Sam-de-Ham/MacroRail/docs/images/module-exploded.png

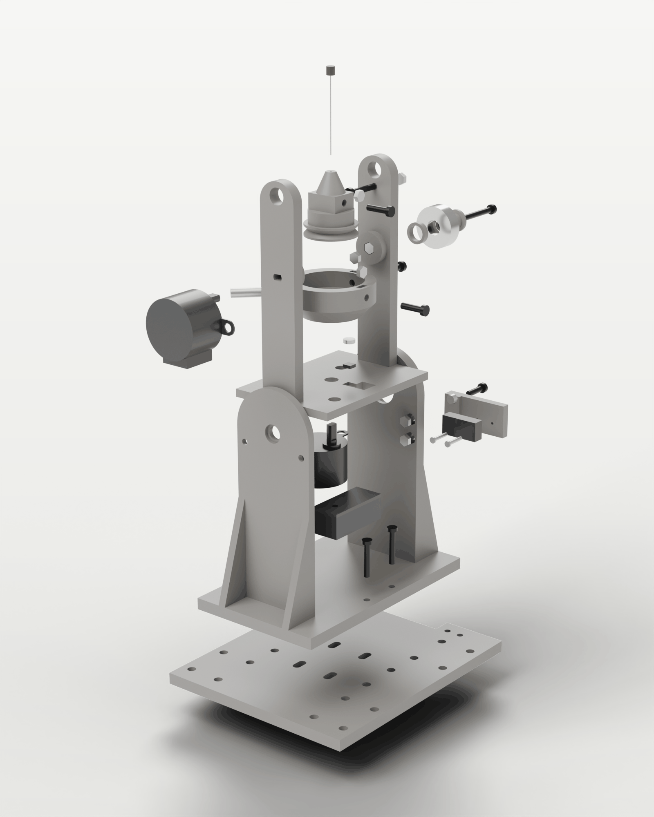
docs/images/module-exploded.png
