Sam-de-Ham/MacroRail/docs/images/rail-exploded.png

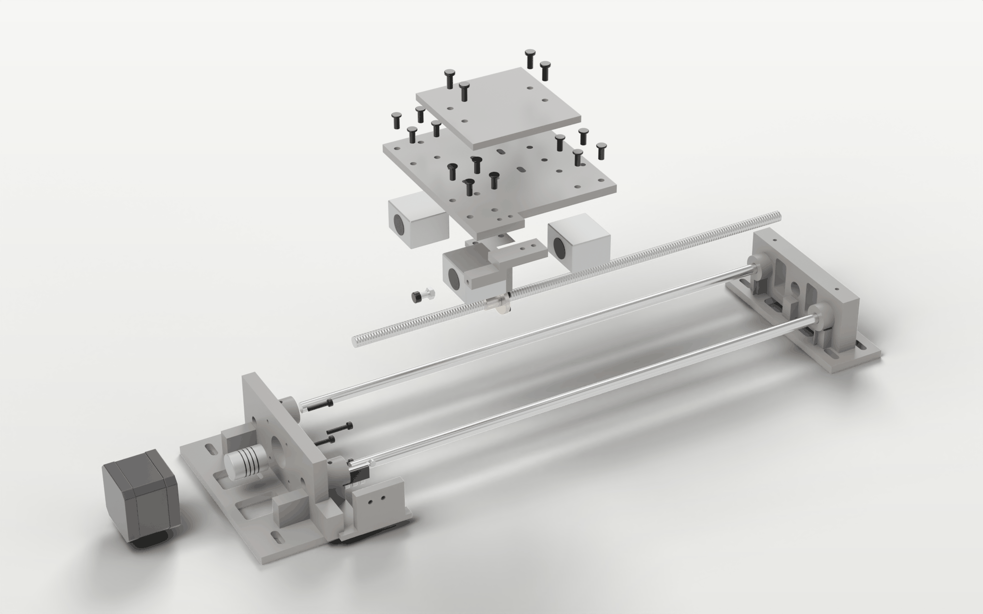
docs/images/rail-exploded.png
