Sam-de-Ham/MacroRail/docs/images/sample/depth.jpg

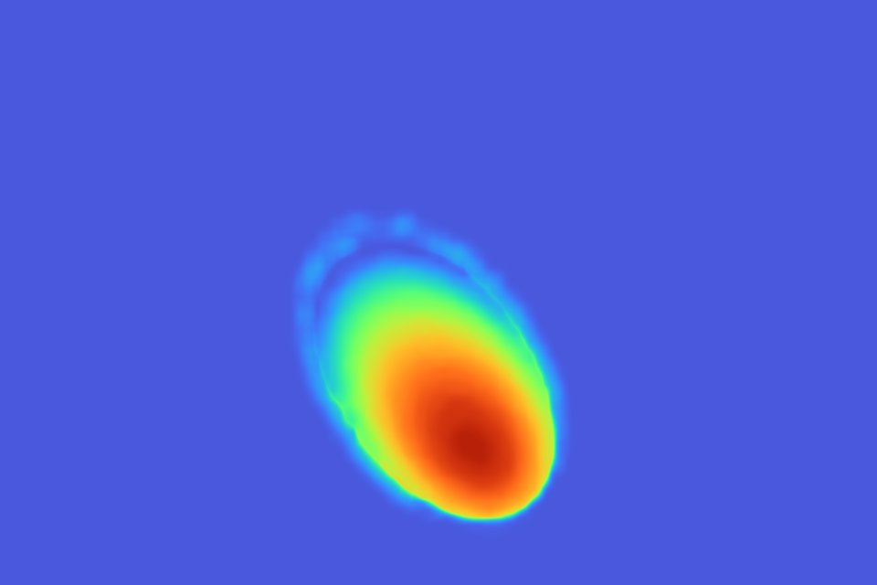
docs/images/sample/depth.jpg
