Sam-de-Ham/MacroRail/docs/images/sample/preview.jpg

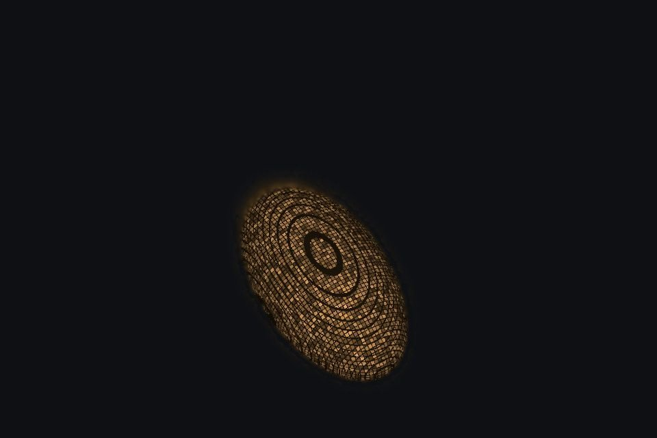
docs/images/sample/preview.jpg
