Sam-de-Ham/MacroRail/docs/images/social-preview.png

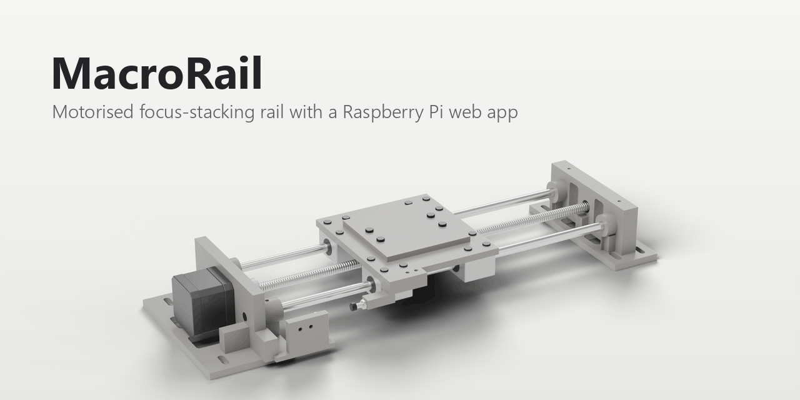
docs/images/social-preview.png
