Sam-de-Ham/MacroRail/hardware/scan-module/exports/final/yaw-head.stl

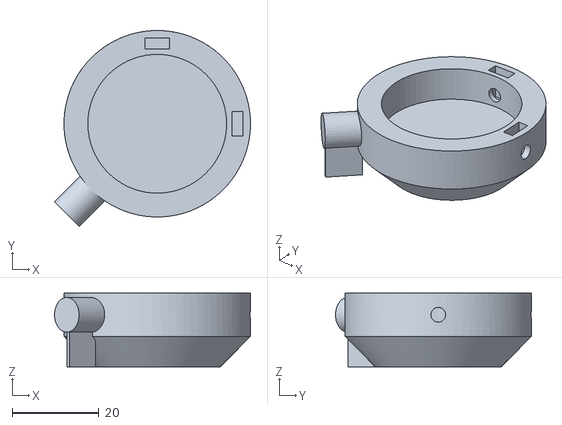
[picture p16: CAD file, 2026-10-23]
hardware/scan-module/exports/final/yaw-head.stl
45.2 x 45.2 x 17.0
