Sam-de-Ham/MacroRail/hardware/rail/stl/05_sample_platform.stl

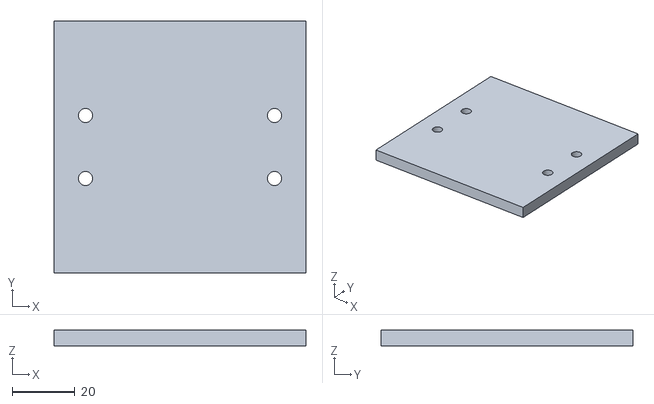
[picture p17: CAD file, 2026-10-18]
hardware/rail/stl/05_sample_platform.stl
80.0 x 80.0 x 5.00
