Sam-de-Ham/MacroRail/hardware/scan-module/exports/final/fork.stl

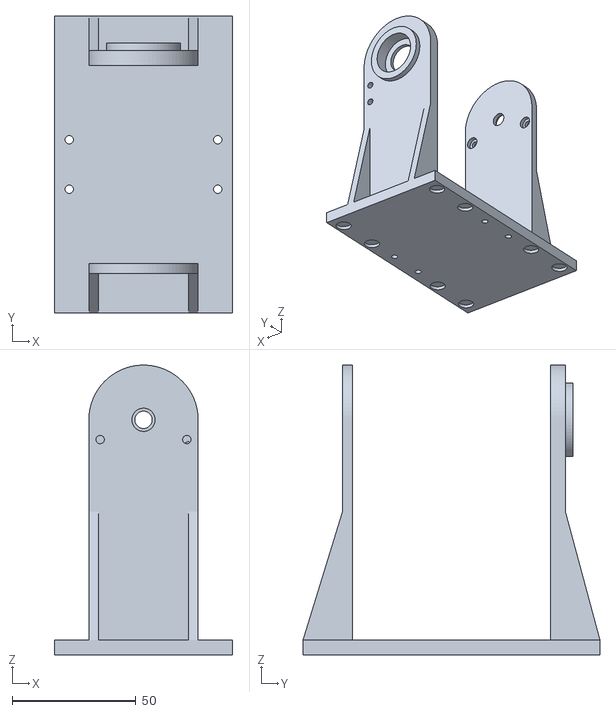
[picture p18: CAD file, 2026-10-22]
hardware/scan-module/exports/final/fork.stl
72.0 x 120.0 x 117.1
