Sam-de-Ham/MacroRail/hardware/scan-module/exports/test-pieces/axle-spacer.stl

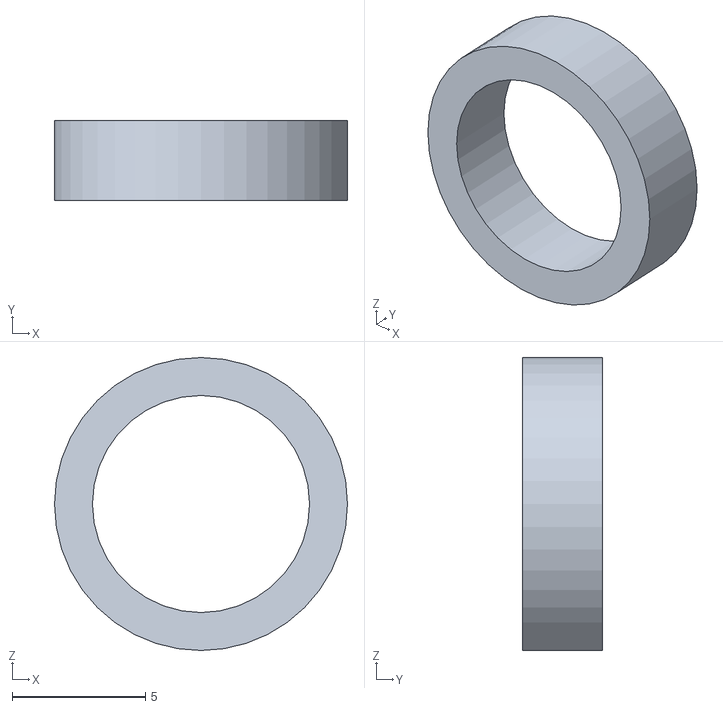
[picture p19: CAD file, 2026-10-22]
hardware/scan-module/exports/test-pieces/axle-spacer.stl
11.0 x 3.00 x 11.0
