Sam-de-Ham/MacroRail/hardware/rail/stl/01_motor_end_block.stl

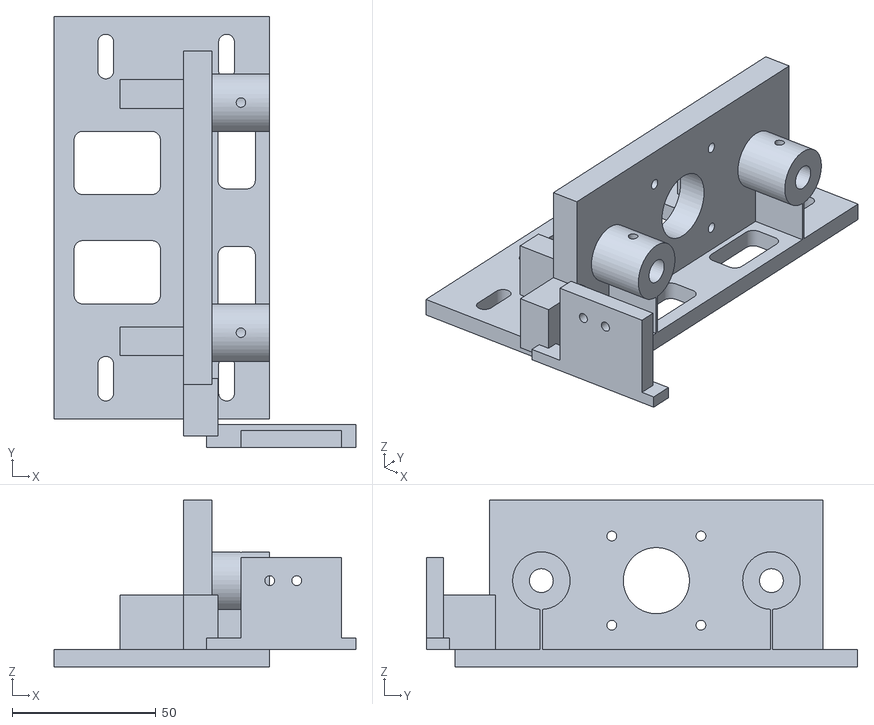
[picture p20: CAD file, 2026-10-18]
hardware/rail/stl/01_motor_end_block.stl
105.0 x 150.0 x 58.0
