Sam-de-Ham/MacroRail/hardware/scan-module/exports/final/cradle.stl

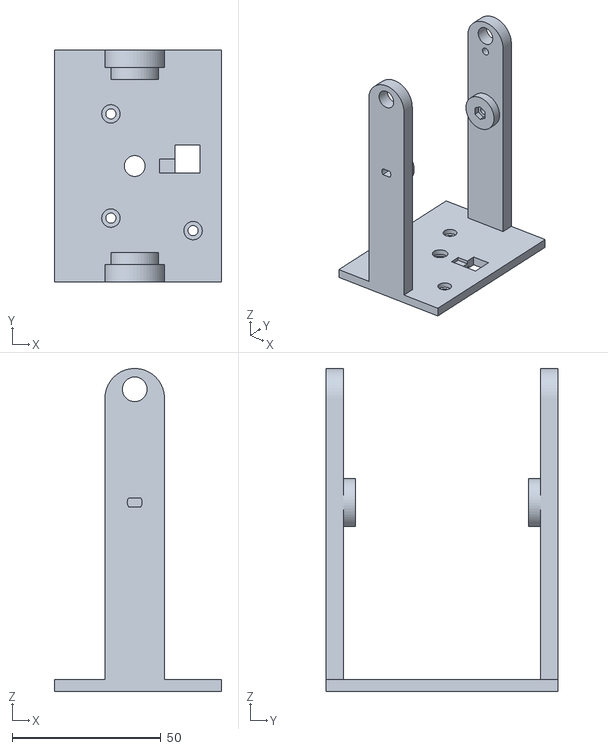
[picture p21: CAD file, 2026-10-22]
hardware/scan-module/exports/final/cradle.stl
56.2 x 78.0 x 108.5
