Sam-de-Ham/MacroRail/hardware/scan-module/exports/test-pieces/specimen-holder.stl

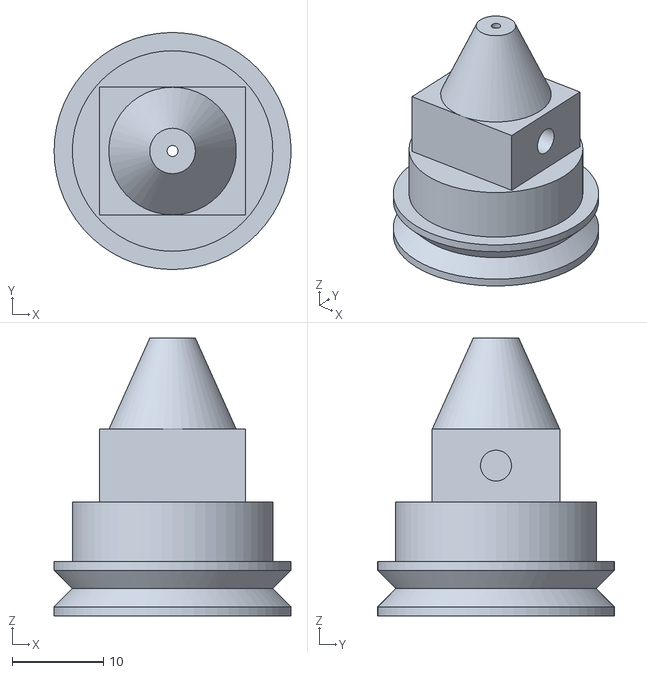
[picture p22: CAD file, 2026-10-22]
hardware/scan-module/exports/test-pieces/specimen-holder.stl
26.0 x 26.0 x 30.5
