Sam-de-Ham/MacroRail/hardware/rail/stl/03_carriage.stl

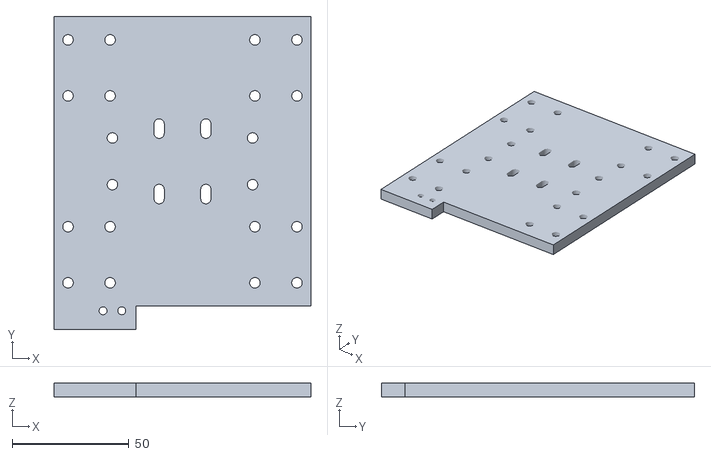
[picture p23: CAD file, 2026-10-18]
hardware/rail/stl/03_carriage.stl
110.0 x 134.0 x 6.00
