Sam-de-Ham/MacroRail/hardware/scan-module/exports/test-pieces/tp-tilt-d-bore.stl

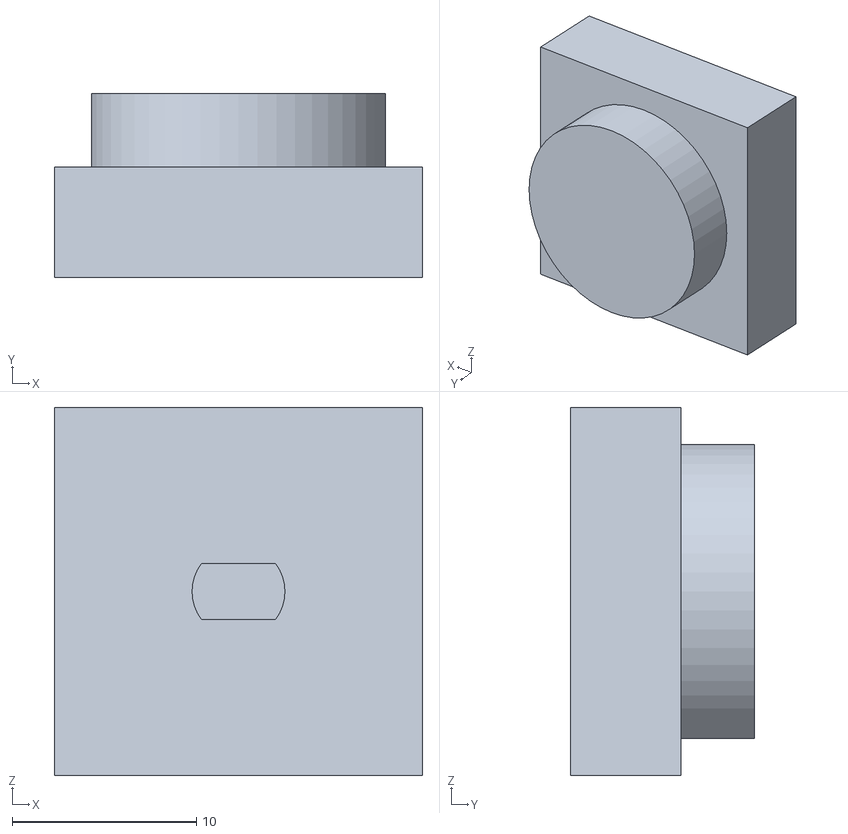
[picture p24: CAD file, 2026-10-22]
hardware/scan-module/exports/test-pieces/tp-tilt-d-bore.stl
20.0 x 10.0 x 20.0
