Sam-de-Ham/MacroRail/hardware/rail/stl/02_far_end_block.stl

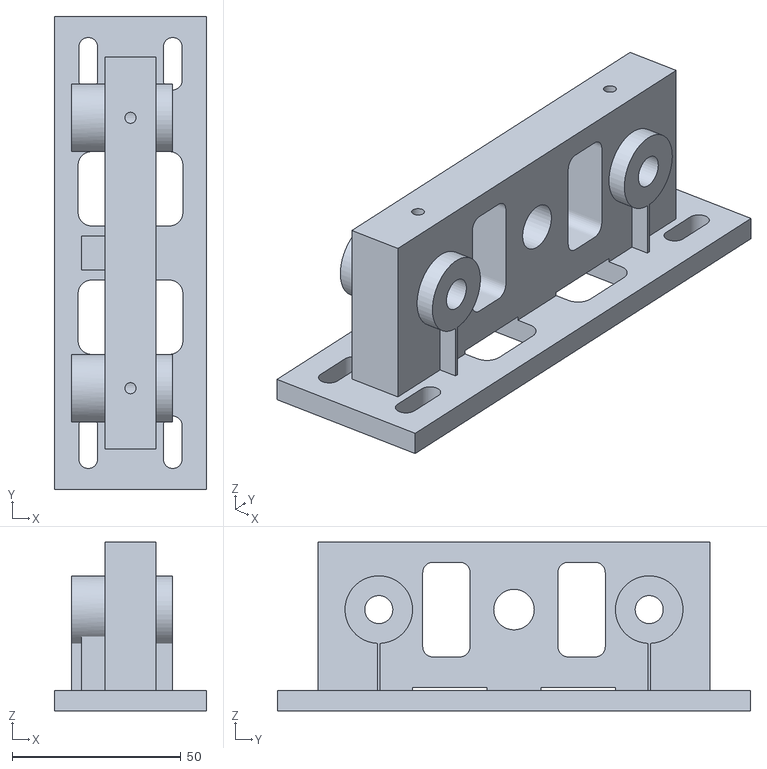
[picture p25: CAD file, 2026-10-18]
hardware/rail/stl/02_far_end_block.stl
45.0 x 140.0 x 50.0
