Sam-de-Ham/MacroRail/hardware/scan-module/exports/final/tilt-axle.stl

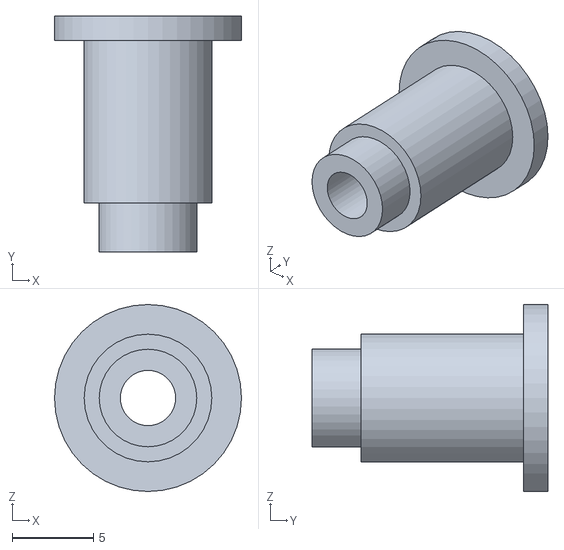
[picture p26: CAD file, 2026-10-22]
hardware/scan-module/exports/final/tilt-axle.stl
11.5 x 14.5 x 11.5
