Sam-de-Ham/MacroRail/hardware/scan-module/exports/test-pieces/tp-bearing-seat.stl

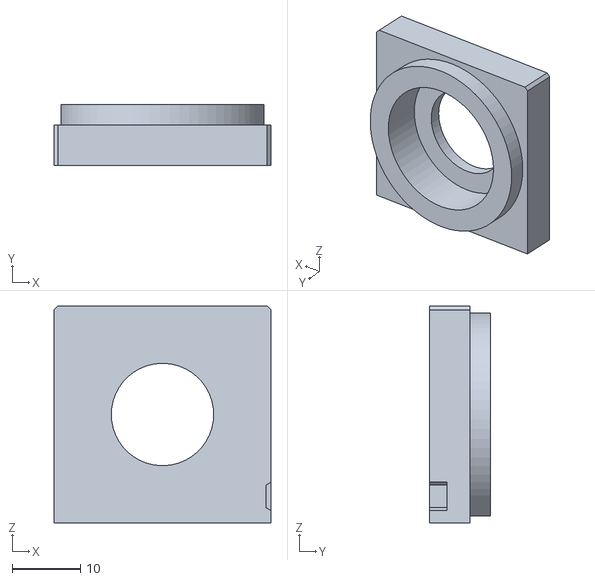
[picture p27: CAD file, 2026-10-22]
hardware/scan-module/exports/test-pieces/tp-bearing-seat.stl
31.8 x 9.00 x 31.8
