Sam-de-Ham/MacroRail/hardware/rail/stl/06_endstop_trigger.stl

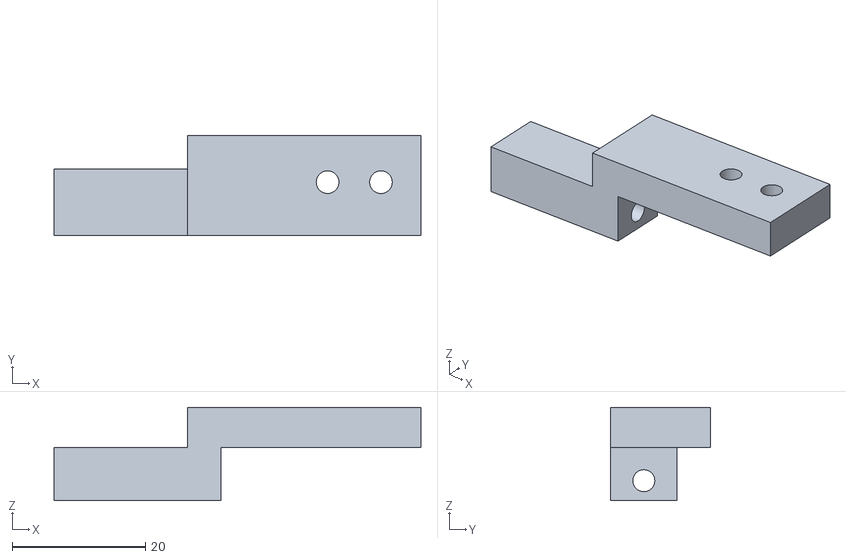
[picture p28: CAD file, 2026-10-18]
hardware/rail/stl/06_endstop_trigger.stl
55.0 x 15.0 x 14.0
