Sam-de-Ham/MacroRail/hardware/scan-module/exports/final/endstop-bracket.stl

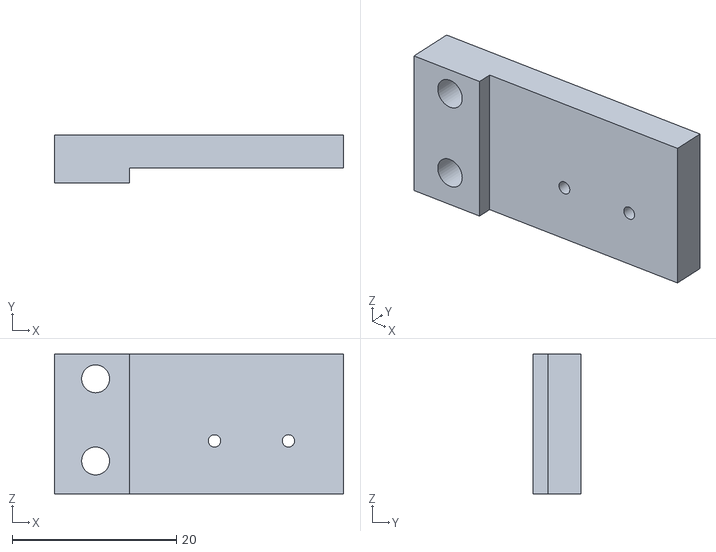
[picture p29: CAD file, 2026-10-21]
hardware/scan-module/exports/final/endstop-bracket.stl
35.2 x 5.80 x 17.0
