Sam-de-Ham/MacroRail/hardware/scan-module/exports/test-pieces/tp-motor-seat.stl

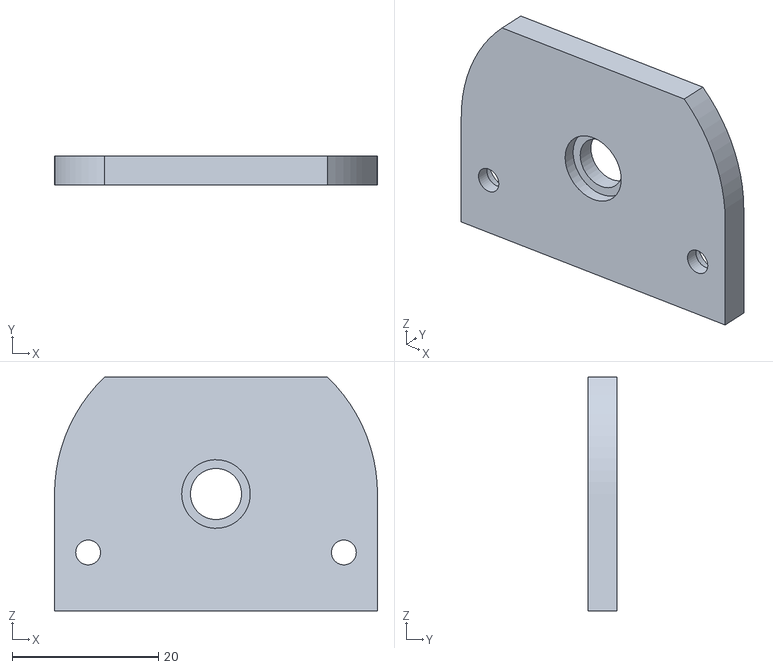
[picture p30: CAD file, 2026-10-22]
hardware/scan-module/exports/test-pieces/tp-motor-seat.stl
44.2 x 4.00 x 32.0
