Sam-de-Ham/MacroRail/hardware/scan-module/exports/final/height-gauge.stl

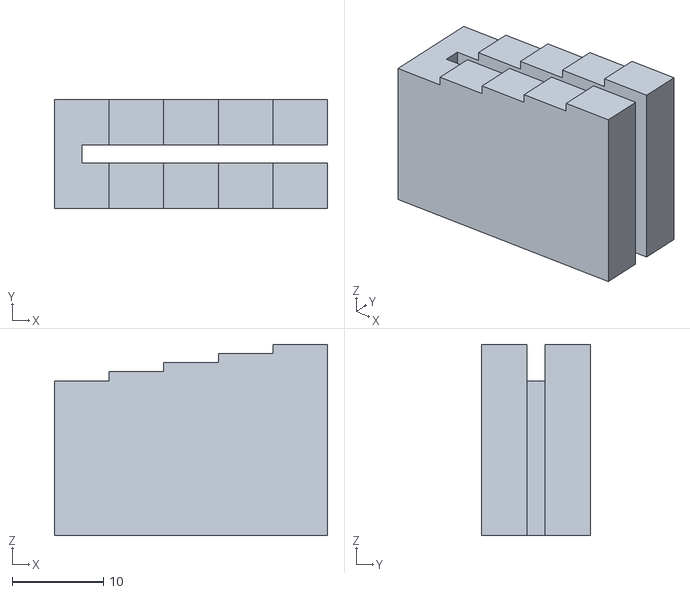
[picture p31: CAD file, 2026-10-21]
hardware/scan-module/exports/final/height-gauge.stl
30.0 x 12.0 x 21.0
