Sam-de-Ham/MacroRail/hardware/scan-module/exports/test-pieces/tp-cradle-floor.stl

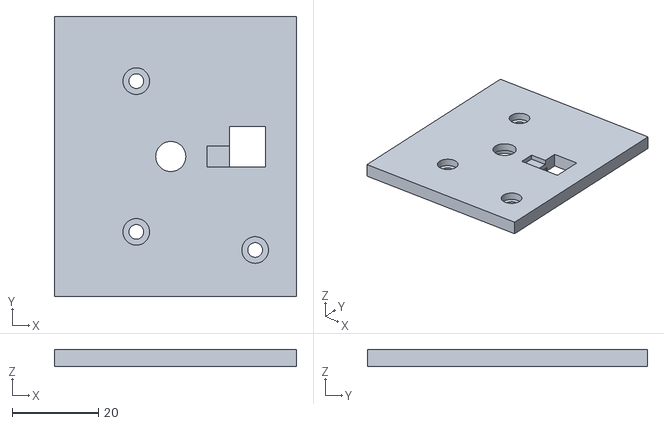
[picture p32: CAD file, 2026-10-21]
hardware/scan-module/exports/test-pieces/tp-cradle-floor.stl
56.2 x 65.0 x 4.00
