Sam-de-Ham/MacroRail/hardware/scan-module/exports/test-pieces/tp-base-holes.stl

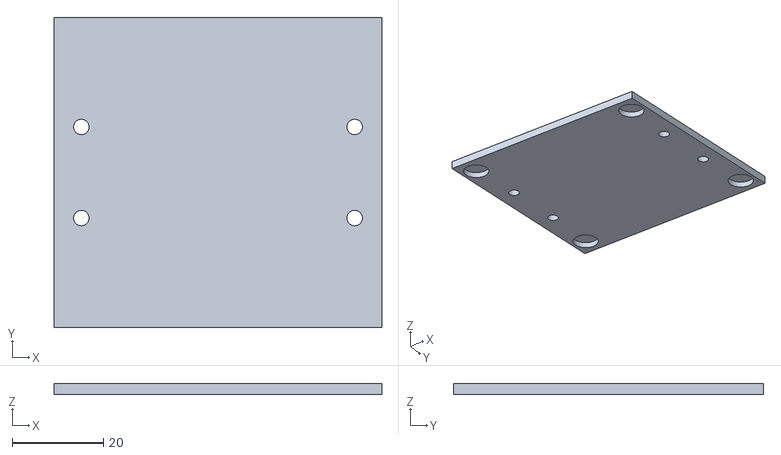
[picture p33: CAD file, 2026-10-21]
hardware/scan-module/exports/test-pieces/tp-base-holes.stl
72.0 x 68.0 x 2.50
