Sam-de-Ham/MacroRail/(list of files, cad)

Other CAD files:
hardware/scan-module/exports/test-pieces/tp-axle-socket.stl
hardware/rail/stl/04_floating_nut_carrier.stl
hardware/scan-module/exports/final/carriage-washer.stl
