Sam-de-Ham/MacroRail/firmware/src/main.cpp

// MacroRail rail controller firmware.
//
// Drives one stepper through a TMC2209 (STEP/DIR for motion, UART for configuration) and
// reads one homing switch. The host talks to it with the line protocol in docs/protocol.md.

#include <AccelStepper.h>
#include <Arduino.h>
#include <TMCStepper.h>

#include "config.h"

namespace {

TMC2209Stepper driver(PIN_UART_RX, PIN_UART_TX, DRIVER_RSENSE_OHM, DRIVER_ADDRESS);
AccelStepper stepper(AccelStepper::DRIVER, PIN_STEP, PIN_DIR);

enum class Motion : uint8_t { None, Move, Jog, HomeSeek, HomeBackoff, HomeProbe };
enum class Abort : uint8_t { None, Stopped, Link };
enum class Fault : uint8_t { None, Overtemp, Short };

struct {
  bool enabled = false;
  bool homed = false;
  bool driverOk = false;
  long minLimit = 0;
  long maxLimit = 0;
  uint16_t runMa = 600;
  uint16_t holdMa = 200;
} state;

struct {
  uint16_t id = 0;
  Motion motion = Motion::None;
  Abort abort = Abort::None;
  bool ignoreSwitch = false;  // backing off a pressed switch: its release bounce must not stop us
  float fast = 0;
  float slow = 0;
  float accel = 0;
  long clearance = 0;   // homing: how far past the release point to back off
  long releaseMax = 0;  // homing: give up if the switch hasn't released by then
  long tripPos = 0;     // homing: where the seek tripped the switch
  long releasePos = 0;  // homing: where it released again (-1 while still pressed)
} pending;

Fault reportedFault = Fault::None;
uint32_t lastRxMs = 0;
uint32_t lastPosMs = 0;
uint32_t lastDriverCheckMs = 0;
float currentAccel = 0;

// ---------------------------------------------------------------------------------------------
// Home switch
//
// A hardware interrupt latches the very first contact, so even a brief touch of a short-throw
// switch stops the motor before its next step, whatever the direction of travel.
// Two latches: `switchTouched` takes any closing edge at all, `switchTripped` only one that is
// still closed when the interrupt runs (a few µs later), which rejects motor-noise spikes.
// Homing expects the switch and uses the first touch, so a chattering contact counts from its
// very first blip; every other motion uses the filtered trip.
// `endstopActive` is the debounced level: it decides whether a move may start, and every
// change of it is reported to the host straight away.

volatile bool switchTouched = false;
volatile bool switchTripped = false;
bool endstopActive = false;
bool endstopRaw = false;
uint32_t endstopChangedUs = 0;
uint32_t endstopSeenUs = 0;  // last time the raw input read "pressed"

bool readEndstopRaw() { return digitalRead(PIN_ENDSTOP) == ENDSTOP_ACTIVE_LEVEL; }

void onSwitchEdge() {
  switchTouched = true;
  if (readEndstopRaw()) switchTripped = true;  // still pressed on entry: not a noise spike
}

void updateEndstop() {
  const bool raw = readEndstopRaw();
  const uint32_t now = micros();
  if (raw) endstopSeenUs = now;
  if (raw != endstopRaw) {
    endstopRaw = raw;
    endstopChangedUs = now;
  } else if (raw != endstopActive && now - endstopChangedUs >= ENDSTOP_DEBOUNCE_US) {
    endstopActive = raw;
    Serial.print(F("! SWITCH pressed="));
    Serial.println(endstopActive);
  }
}

// ---------------------------------------------------------------------------------------------
// Replies and events

void beginReply(uint16_t id) {
  Serial.print(id);
  Serial.print(' ');
}

void replyOk(uint16_t id) {
  beginReply(id);
  Serial.println(F("OK"));
}

void replyOkPos(uint16_t id) {
  beginReply(id);
  Serial.print(F("OK pos="));
  Serial.println(stepper.currentPosition());
}

void replyErr(uint16_t id, const __FlashStringHelper* code) {
  beginReply(id);
  Serial.print(F("ERR "));
  Serial.println(code);
}

void replyErrPos(uint16_t id, const __FlashStringHelper* code) {
  beginReply(id);
  Serial.print(F("ERR "));
  Serial.print(code);
  Serial.print(F(" pos="));
  Serial.println(stepper.currentPosition());
}

void printIdentity() {
  Serial.print(F("fw=" FIRMWARE_VERSION " proto="));
  Serial.print(PROTOCOL_VERSION);
  Serial.print(F(" driver="));
  Serial.println(state.driverOk ? F("ok") : F("missing"));
}

// ---------------------------------------------------------------------------------------------
// Driver

void applyCurrent() {
  driver.rms_current(state.runMa, static_cast<float>(state.holdMa) / state.runMa);
}

bool configureDriver() {
  if (driver.version() != TMC2209_VERSION) return false;
  driver.GSTAT(0);  // clear reset/error flags (write-1-to-clear)
  driver.pdn_disable(true);       // PDN_UART pin is UART, not power-down
  driver.mstep_reg_select(true);  // microsteps from register, not MS1/MS2
  driver.I_scale_analog(false);   // current from register, not VREF
  driver.toff(4);
  driver.microsteps(MICROSTEPS);
  driver.intpol(true);            // interpolate to 256 microsteps
  driver.en_spreadCycle(false);   // StealthChop
  driver.pwm_autoscale(true);
  driver.pwm_autograd(true);
  driver.TCOOLTHRS(0);            // StallGuard/CoolStep unused
  driver.SGTHRS(0);
  driver.semin(0);
  driver.iholddelay(8);
  driver.TPOWERDOWN(20);
  applyCurrent();
  return driver.microsteps() == MICROSTEPS;
}

void disableMotor() {
  stepper.disableOutputs();
  state.enabled = false;
  state.homed = false;
}

void fault(const __FlashStringHelper* code) {
  disableMotor();
  Serial.print(F("! FAULT code="));
  Serial.println(code);
}

// The driver UART (SoftwareSerial) blocks interrupts for each byte, long enough to drop bytes
// arriving from the host and to stall the step loop. So it is used only while answering a host
// request that the host waits for (STATUS when idle, ENABLE, CURRENT), never while moving.
void checkDriver() {
  if (driver.version() != TMC2209_VERSION) {
    if (state.driverOk) {
      state.driverOk = false;
      fault(F("driver_lost"));
    }
    return;
  }
  if (!state.driverOk) {  // came back (e.g. 12 V switched on): configure, motor stays off
    state.driverOk = configureDriver();
    return;
  }
  if (driver.GSTAT() & 0x01) {  // reset: registers lost power
    state.driverOk = configureDriver();
    fault(F("driver_reset"));
    return;
  }
  // Overtemperature and short flags stay set while the condition lasts: report each once.
  Fault now = Fault::None;
  if (driver.ot()) now = Fault::Overtemp;
  else if (driver.s2ga() || driver.s2gb() || driver.s2vsa() || driver.s2vsb()) now = Fault::Short;
  if (now != reportedFault && now != Fault::None) {
    fault(now == Fault::Overtemp ? F("overtemp") : F("short"));
  }
  reportedFault = now;
}

// ---------------------------------------------------------------------------------------------
// Motion

void setProfile(float speed, float accel) {
  stepper.setMaxSpeed(speed);
  if (accel != currentAccel) {  // setAcceleration is comparatively expensive
    stepper.setAcceleration(accel);
    currentAccel = accel;
  }
}

void haltNow() { stepper.setCurrentPosition(stepper.currentPosition()); }

void finish() {
  pending.id = 0;
  pending.motion = Motion::None;
  pending.abort = Abort::None;
  pending.ignoreSwitch = false;
}

void finishOk() {
  replyOkPos(pending.id);
  finish();
}

void finishErr(const __FlashStringHelper* code) {
  replyErrPos(pending.id, code);
  finish();
}

void startHomeSeek(long maxSteps) {
  setProfile(pending.fast, pending.accel);
  stepper.move(-maxSteps);
  pending.motion = Motion::HomeSeek;
  pending.ignoreSwitch = false;
}

// Back away until the switch has stayed released for the debounce time, then `clearance`
// further. Roller-lever switches release well past the point where they trip, so a fixed
// back-off distance can end with the switch still closed.
void startHomeBackoff() {
  pending.tripPos = stepper.currentPosition();
  pending.releasePos = -1;
  endstopSeenUs = micros();  // it is pressed now, even if the debounced level hasn't caught up
  setProfile(pending.fast, pending.accel);
  stepper.move(pending.releaseMax);
  pending.motion = Motion::HomeBackoff;
  pending.ignoreSwitch = true;
}

void serviceHomeBackoff(bool done) {
  const bool released = micros() - endstopSeenUs >= ENDSTOP_DEBOUNCE_US;
  if (pending.releasePos < 0 && released) {
    pending.releasePos = stepper.currentPosition();
    stepper.moveTo(pending.releasePos + pending.clearance);
    return;
  }
  if (!done) return;
  if (pending.releasePos < 0) return finishErr(F("SWITCH_STUCK"));
  // Probe slowly back toward the switch; it should trip near tripPos.
  setProfile(pending.slow, pending.accel);
  stepper.moveTo(pending.tripPos - pending.clearance);
  pending.motion = Motion::HomeProbe;
  pending.ignoreSwitch = false;
}

void finishHome() {
  const long release = pending.releasePos - pending.tripPos;
  stepper.setCurrentPosition(0);
  state.homed = true;
  beginReply(pending.id);
  Serial.print(F("OK pos=0 release="));
  Serial.println(release);
  finish();
}

void serviceMotion() {
  // Consume a latched trip first, so a touch stops the motor before its next step.
  noInterrupts();  // read-and-clear must not lose a trip that lands in between
  const bool touched = switchTouched;
  const bool filtered = switchTripped;
  switchTouched = switchTripped = false;
  interrupts();
  if (pending.motion == Motion::None) return;  // a touch while idle stops nothing

  const bool homing = pending.motion == Motion::HomeSeek || pending.motion == Motion::HomeProbe;
  const bool trip = homing ? touched : filtered;
  const bool linearMove = pending.motion == Motion::Move || pending.motion == Motion::Jog;
  // A move that started on the pressed switch ignores it only until it has released.
  if (linearMove && pending.ignoreSwitch && micros() - endstopSeenUs >= ENDSTOP_DEBOUNCE_US) {
    pending.ignoreSwitch = false;
  }
  const bool tripped = trip && !pending.ignoreSwitch;
  if (tripped) haltNow();
  else stepper.run();

  const bool done = !stepper.isRunning();
  if (tripped && linearMove) state.homed = false;

  if (pending.abort != Abort::None) {
    if (done || tripped) finishErr(pending.abort == Abort::Stopped ? F("STOPPED") : F("LINK"));
    return;
  }

  switch (pending.motion) {
    case Motion::HomeSeek:
      if (tripped) startHomeBackoff();
      else if (done) finishErr(F("NO_SWITCH"));
      break;
    case Motion::HomeBackoff:
      serviceHomeBackoff(done);
      break;
    case Motion::HomeProbe:
      if (tripped) finishHome();
      else if (done) finishErr(F("NO_SWITCH"));
      break;
    case Motion::Move:
    case Motion::Jog:
      if (tripped) finishErr(F("ENDSTOP"));
      else if (done) finishOk();
      break;
    case Motion::None:
      break;
  }
}

// ---------------------------------------------------------------------------------------------
// Commands

bool parseLong(const char* text, long& out) {
  char* end = nullptr;
  out = strtol(text, &end, 10);
  return end != text && *end == '\0';
}

bool validProfile(long speed, long accel) {
  return speed > 0 && speed <= SPEED_MAX && accel > 0 && accel <= ACCEL_MAX;
}

bool withinLimits(long target) { return target >= state.minLimit && target <= state.maxLimit; }

void cmdInfo(uint16_t id, const long*) {
  beginReply(id);
  Serial.print(F("OK "));
  printIdentity();
}

void cmdStatus(uint16_t id, const long*) {
  const uint32_t now = millis();
  if (pending.motion == Motion::None && now - lastDriverCheckMs >= DRIVER_CHECK_MS) {
    lastDriverCheckMs = now;
    checkDriver();
  }
  beginReply(id);
  Serial.print(F("OK pos="));
  Serial.print(stepper.currentPosition());
  Serial.print(F(" homed="));
  Serial.print(state.homed);
  Serial.print(F(" enabled="));
  Serial.print(state.enabled);
  Serial.print(F(" moving="));
  Serial.print(pending.motion != Motion::None);
  Serial.print(F(" endstop="));
  Serial.print(endstopActive);
  Serial.print(F(" driver="));
  Serial.println(state.driverOk ? F("ok") : F("missing"));
}

// Driver health for diagnostics, decoded from one DRV_STATUS read. Idle only (driver UART).
void cmdDriver(uint16_t id, const long*) {
  if (!state.driverOk) return replyErr(id, F("DRIVER"));
  const uint32_t s = driver.DRV_STATUS();
  const uint8_t temp = (s & (1UL << 11)) ? 157 : (s & (1UL << 10)) ? 150
                     : (s & (1UL << 9))  ? 143 : (s & (1UL << 8))  ? 120 : 0;
  beginReply(id);
  Serial.print(F("OK cs="));
  Serial.print((s >> 16) & 0x1F);
  Serial.print(F(" stealth="));
  Serial.print((s >> 30) & 1);
  Serial.print(F(" stst="));
  Serial.print((s >> 31) & 1);
  Serial.print(F(" temp="));
  Serial.print(temp);
  Serial.print(F(" otpw="));
  Serial.print(s & 1);
  Serial.print(F(" ot="));
  Serial.print((s >> 1) & 1);
  Serial.print(F(" short="));
  Serial.print((s & 0b111100) ? 1 : 0);
  Serial.print(F(" openload="));
  Serial.print((s >> 6) & 0b11 ? 1 : 0);
  Serial.print(F(" irun="));
  Serial.print(driver.irun());
  Serial.print(F(" ihold="));
  Serial.print(driver.ihold());
  Serial.print(F(" mres="));
  Serial.print(driver.microsteps());
  Serial.print(F(" up="));
  Serial.println(millis() / 1000);
}

void cmdStop(uint16_t id, const long*) {
  if (pending.motion != Motion::None && pending.abort == Abort::None) {
    pending.abort = Abort::Stopped;
    stepper.stop();
  }
  replyOk(id);
}

void cmdEnable(uint16_t id, const long*) {
  if (!state.driverOk) state.driverOk = configureDriver();
  if (!state.driverOk) return replyErr(id, F("DRIVER"));
  if (!state.enabled) {
    // StealthChop calibrates (AT#1) at standstill with run current: hold IRUN for >130 ms.
    driver.rms_current(state.runMa, 1.0f);
    stepper.enableOutputs();
    delay(200);
    applyCurrent();
    state.enabled = true;
  }
  replyOk(id);
}

void cmdDisable(uint16_t id, const long*) {
  disableMotor();
  replyOk(id);
}

void cmdCurrent(uint16_t id, const long* args) {
  const long run = args[0];
  const long hold = args[1];
  if (run < CURRENT_MIN_MA || run > CURRENT_MAX_MA || hold < 0 || hold > run) {
    return replyErr(id, F("ARG"));
  }
  state.runMa = run;
  state.holdMa = hold;
  if (state.driverOk) applyCurrent();
  replyOk(id);
}

void cmdLimits(uint16_t id, const long* args) {
  if (args[0] > args[1]) return replyErr(id, F("ARG"));
  state.minLimit = args[0];
  state.maxLimit = args[1];
  replyOk(id);
}

void cmdHome(uint16_t id, const long* args) {
  const long fast = args[0], slow = args[1], clearance = args[2], maxSteps = args[3],
             releaseMax = args[4], accel = args[5];
  if (!validProfile(fast, accel) || !validProfile(slow, accel) || clearance <= 0 ||
      maxSteps <= 0 || releaseMax <= clearance) {
    return replyErr(id, F("ARG"));
  }
  if (!state.enabled) return replyErr(id, F("DISABLED"));
  state.homed = false;
  pending.id = id;
  pending.fast = fast;
  pending.slow = slow;
  pending.accel = accel;
  pending.clearance = clearance;
  pending.releaseMax = releaseMax;
  lastPosMs = millis();
  if (endstopActive) startHomeBackoff();
  else startHomeSeek(maxSteps);
}

// Starts a move or jog. While the switch is pressed only moves away from it may start; those
// ignore it until it has released (bounce included), then it is armed again. Every other move
// stops on the first touch.
void startLinear(uint16_t id, Motion motion, long target, long speed, long accel) {
  if (endstopActive && target < stepper.currentPosition()) return replyErrPos(id, F("ENDSTOP"));
  if (target == stepper.currentPosition()) return replyOkPos(id);
  pending.id = id;
  pending.motion = motion;
  pending.ignoreSwitch = endstopActive;
  setProfile(speed, accel);
  stepper.moveTo(target);
  lastPosMs = millis();
}

void cmdMove(uint16_t id, const long* args) {
  const long target = args[0];
  if (!validProfile(args[1], args[2])) return replyErr(id, F("ARG"));
  if (!state.enabled) return replyErr(id, F("DISABLED"));
  if (!state.homed) return replyErr(id, F("NOT_HOMED"));
  if (!withinLimits(target)) return replyErr(id, F("LIMIT"));
  startLinear(id, Motion::Move, target, args[1], args[2]);
}

void cmdJog(uint16_t id, const long* args) {
  const long delta = args[0];
  const long target = stepper.currentPosition() + delta;
  if (!validProfile(args[1], args[2])) return replyErr(id, F("ARG"));
  if (!state.enabled) return replyErr(id, F("DISABLED"));
  if (state.homed && !withinLimits(target)) return replyErr(id, F("LIMIT"));
  startLinear(id, Motion::Jog, target, args[1], args[2]);
}

struct Command {
  const char* name;  // in flash
  uint8_t arity;
  bool allowedWhileMoving;
  void (*run)(uint16_t id, const long* args);
};

const char N_INFO[] PROGMEM = "INFO";
const char N_STATUS[] PROGMEM = "STATUS";
const char N_STOP[] PROGMEM = "STOP";
const char N_ENABLE[] PROGMEM = "ENABLE";
const char N_DISABLE[] PROGMEM = "DISABLE";
const char N_CURRENT[] PROGMEM = "CURRENT";
const char N_LIMITS[] PROGMEM = "LIMITS";
const char N_HOME[] PROGMEM = "HOME";
const char N_MOVE[] PROGMEM = "MOVE";
const char N_JOG[] PROGMEM = "JOG";
const char N_DRIVER[] PROGMEM = "DRIVER";

const Command COMMANDS[] = {
    {N_INFO, 0, true, cmdInfo},          {N_STATUS, 0, true, cmdStatus},
    {N_STOP, 0, true, cmdStop},
    {N_ENABLE, 0, false, cmdEnable},     {N_DISABLE, 0, false, cmdDisable},
    {N_CURRENT, 2, false, cmdCurrent},   {N_LIMITS, 2, false, cmdLimits},
    {N_HOME, 6, false, cmdHome},         {N_MOVE, 3, false, cmdMove},
    {N_JOG, 3, false, cmdJog},           {N_DRIVER, 0, false, cmdDriver},
};

void handleLine(char* text) {
  constexpr uint8_t MAX_ARGS = 6;
  char* save = nullptr;
  const char* idText = strtok_r(text, " ", &save);
  const char* name = strtok_r(nullptr, " ", &save);
  long id = 0;
  if (!idText || !name || !parseLong(idText, id) || id < 1 || id > 65535) {
    return replyErr(0, F("SYNTAX"));
  }

  long args[MAX_ARGS];
  uint8_t argc = 0;
  for (const char* tok; (tok = strtok_r(nullptr, " ", &save));) {
    if (argc == MAX_ARGS || !parseLong(tok, args[argc++])) return replyErr(id, F("ARG"));
  }

  for (const Command& command : COMMANDS) {
    if (strcmp_P(name, command.name) != 0) continue;
    if (argc != command.arity) return replyErr(id, F("ARG"));
    if (pending.motion != Motion::None && !command.allowedWhileMoving) {
      return replyErr(id, F("BUSY"));
    }
    return command.run(id, args);
  }
  replyErr(id, F("UNKNOWN"));
}

// ---------------------------------------------------------------------------------------------
// Host link

char line[LINE_MAX];
uint8_t lineLength = 0;
bool lineOverflow = false;

void pollSerial() {
  while (Serial.available() > 0) {
    const char c = static_cast<char>(Serial.read());
    if (c == '\r') continue;
    if (c != '\n') {
      if (lineLength < LINE_MAX - 1) line[lineLength++] = c;
      else lineOverflow = true;
      continue;
    }
    lastRxMs = millis();
    if (lineOverflow) {
      replyErr(0, F("TOOLONG"));
    } else if (lineLength > 0) {
      line[lineLength] = '\0';
      handleLine(line);
    }
    lineLength = 0;
    lineOverflow = false;
  }
}

void serviceTimers() {
  const uint32_t now = millis();
  if (pending.motion != Motion::None) {
    if (pending.abort == Abort::None && now - lastRxMs > LINK_TIMEOUT_MS) {
      pending.abort = Abort::Link;
      stepper.stop();
    }
    if (now - lastPosMs >= POS_REPORT_MS) {
      lastPosMs = now;
      Serial.print(F("! POS pos="));
      Serial.println(stepper.currentPosition());
    }
  }
}

}  // namespace

void setup() {
  pinMode(PIN_ENDSTOP, INPUT_PULLUP);
  stepper.setPinsInverted(INVERT_DIRECTION, false, true);  // EN is active low
  stepper.setEnablePin(PIN_ENABLE);
  stepper.disableOutputs();

  Serial.begin(SERIAL_BAUD);
  driver.beginSerial(DRIVER_UART_BAUD);
  state.driverOk = configureDriver();

  endstopRaw = endstopActive = readEndstopRaw();
  attachInterrupt(digitalPinToInterrupt(PIN_ENDSTOP), onSwitchEdge,
                  ENDSTOP_ACTIVE_LEVEL == LOW ? FALLING : RISING);
  lastRxMs = lastDriverCheckMs = millis();

  Serial.print(F("! READY "));
  printIdentity();
}

void loop() {
  serviceMotion();
  pollSerial();
  serviceMotion();
  updateEndstop();
  serviceTimers();
}
