Sam-de-Ham/MacroRail/src/macrorail/motion/rail.py

"""The macro rail: an Arduino Nano + TMC2209 running `firmware/`, reached through a Link."""

from __future__ import annotations

import asyncio
import logging
import time
from collections.abc import Callable
from dataclasses import replace

from ..config import RailConfig
from ..log import ActivityLog
from .base import AxisError, AxisState, MotionInterrupted, motion_time
from .link import DeviceError, Link, LinkError, Transport
from .ports import AUTO
from .protocol import PROTOCOL_VERSION, Event

logger = logging.getLogger(__name__)

STATUS_INTERVAL_S = 0.5
RETRY_INTERVAL_S = 2.0

_ERRORS = {
    "BUSY": "The rail is busy.",
    "DISABLED": "The motor is off.",
    "NOT_HOMED": "Home the rail first.",
    "LIMIT": "That position is outside the rail's travel.",
    "DRIVER": "The stepper driver is not responding. Check the 12 V supply and its wiring.",
    "ENDSTOP": "The home switch was hit unexpectedly. Home the rail again.",
    "NO_SWITCH": "Homing did not find the switch. Check the switch and its wiring.",
    "SWITCH_STUCK": "The home switch stayed pressed after backing off. Check the switch.",
    "LINK": "The controller stopped the motor because it lost contact with the Pi.",
}

_FAULTS = {
    "driver_lost": "The stepper driver stopped responding. Check the 12 V supply.",
    "driver_reset": "The stepper driver lost power and restarted. Home the rail again.",
    "overtemp": "The stepper driver overheated, so the motor was switched off.",
    "short": "The stepper driver detected a short circuit, so the motor was switched off.",
}


class RailAxis:
    def __init__(
        self,
        config: RailConfig,
        open_transport: Callable[[], Transport],
        log: ActivityLog,
        on_change: Callable[[], None],
    ) -> None:
        self._config = config
        self._open_transport = open_transport
        self._log = log
        self._on_change = on_change
        self.steps_per_mm = config.steps_per_mm
        self.min_position = round(config.min_mm * config.steps_per_mm)
        self.max_position = round(config.travel_mm * config.steps_per_mm)
        self._state = AxisState(problem="Connecting to the rail controller…")
        self._link: Link | None = None
        self._current = (600, 200)
        # Link health, for diagnostics.
        self._connections = 0
        self._connected_since: float | None = None
        self._status_ms: float | None = None  # smoothed STATUS round trip

    @property
    def state(self) -> AxisState:
        return self._state

    # -- connection ---------------------------------------------------------------------------

    async def run(self) -> None:
        last_problem: str | None = None
        while True:
            try:
                await self._session()
                problem = "Lost connection to the rail controller."
            except (LinkError, OSError, AxisError) as exc:
                problem = self._describe_failure(exc)
            except Exception as exc:  # the supervisor must outlive any bug: reconnect instead
                logger.exception("rail session failed")
                problem = f"Rail controller error ({exc}). Reconnecting."

            if self._state.connected or problem != last_problem:
                self._log.warning(problem)
            last_problem = problem
            self._update(connected=False, moving=False, problem=problem)
            await asyncio.sleep(RETRY_INTERVAL_S)

    async def _session(self) -> None:
        link, ready = await Link.open(self._open_transport, self._on_event)
        try:
            if ready.data.get("role") == "module":
                raise AxisError(
                    f"{self._config.port} is the scan module's controller, not the rail's. Set "
                    'the rail\'s port to "auto" in config.toml.'
                )
            if ready.data.get("proto") != str(PROTOCOL_VERSION):
                raise AxisError(
                    f"The rail firmware speaks protocol {ready.data.get('proto')}, but this app "
                    f"needs {PROTOCOL_VERSION}. Flash the firmware that ships with this version."
                )
            await link.request("CURRENT", *self._current)
            await link.request("LIMITS", self.min_position, self.max_position)
            self._link = link
            self._apply_status(await link.request("STATUS"), firmware=ready.data.get("fw"))
            self._connections += 1
            self._connected_since = time.time()
            self._log.info(f"Rail controller connected (firmware {self._state.firmware}).")
            while True:
                await asyncio.sleep(STATUS_INTERVAL_S)
                sent = time.perf_counter()
                status = await link.request("STATUS")
                ms = (time.perf_counter() - sent) * 1000
                self._status_ms = (
                    ms if self._status_ms is None else 0.8 * self._status_ms + 0.2 * ms
                )
                self._apply_status(status)
        finally:
            self._link = None
            self._connected_since = None
            await link.close()

    def _describe_failure(self, exc: Exception) -> str:
        if isinstance(exc, AxisError):
            return str(exc)
        if isinstance(exc, OSError):
            if self._config.port == AUTO:
                return "Rail controller not found. Is its Nano plugged in?"
            return f"Rail controller not found on {self._config.port}. Is the Nano plugged in?"
        return f"Lost connection to the rail controller ({exc})."

    def _on_event(self, event: Event) -> None:
        if event.name == "POS":
            self._update(position=int(event.data["pos"]))
        elif event.name == "SWITCH":
            self._update(endstop=event.data.get("pressed") == "1")
        elif event.name == "FAULT":
            code = event.data.get("code", "")
            self._log.error(_FAULTS.get(code, f"Stepper driver fault: {code}."))
            if code == "driver_lost":
                self._update(enabled=False, homed=False, driver_ok=False, problem=_ERRORS["DRIVER"])
            else:
                self._update(enabled=False, homed=False)
        elif event.name == "READY" and self._link is not None:
            self._link.abort("the controller restarted")

    def _apply_status(self, data: dict[str, str], firmware: str | None = None) -> None:
        driver_ok = data["driver"] == "ok"
        self._update(
            connected=True,
            driver_ok=driver_ok,
            enabled=data["enabled"] == "1",
            homed=data["homed"] == "1",
            moving=data["moving"] == "1",
            endstop=data["endstop"] == "1",
            position=int(data["pos"]),
            firmware=firmware or self._state.firmware,
            problem=None if driver_ok else _ERRORS["DRIVER"],
        )

    def _update(self, **changes: object) -> None:
        new = replace(self._state, **changes)  # type: ignore[arg-type]
        if new != self._state:
            self._state = new
            self._on_change()

    # -- commands -----------------------------------------------------------------------------

    async def _request(
        self, command: str, *args: int, timeout: float = 1.0, motion: bool = False
    ) -> dict[str, str]:
        link = self._link
        if link is None:
            raise AxisError(self._state.problem or "The rail controller is not connected.")
        try:
            data = await link.request(command, *args, timeout=timeout, motion=motion)
        except DeviceError as exc:
            if "pos" in exc.data:
                self._update(position=int(exc.data["pos"]))
            if exc.code == "ENDSTOP":
                self._update(homed=False)  # as the controller just did
            if exc.code == "STOPPED":
                raise MotionInterrupted("Stopped.") from None
            raise AxisError(_ERRORS.get(exc.code, f"Rail controller error {exc.code}.")) from None
        except LinkError as exc:
            raise AxisError(f"Lost connection to the rail controller ({exc}).") from None
        if "pos" in data:
            self._update(position=int(data["pos"]))
        return data

    async def _motion(self, command: str, *args: int, timeout: float) -> dict[str, str]:
        self._update(moving=True)
        try:
            return await self._request(command, *args, timeout=timeout, motion=True)
        finally:
            self._update(moving=False)

    def diagnostics(self) -> dict[str, object]:
        link = self._link
        return {
            "port": (link.port if link is not None else None) or self._config.port,
            "protocol": PROTOCOL_VERSION,
            "connections": self._connections,
            "connected_since": self._connected_since,
            "status_ms": None if self._status_ms is None else round(self._status_ms, 1),
        }

    async def read_driver(self) -> dict[str, str]:
        """The driver's status registers (only while idle: the controller refuses it moving)."""
        return await self._request("DRIVER")

    async def set_current(self, run_ma: int, hold_ma: int) -> None:
        self._current = (run_ma, hold_ma)
        if self._link is not None:
            await self._request("CURRENT", run_ma, hold_ma)

    async def enable(self) -> None:
        await self._request("ENABLE")
        self._update(enabled=True)

    async def disable(self) -> None:
        await self._request("DISABLE")
        self._update(enabled=False, homed=False)

    async def home(self) -> None:
        c, spm = self._config, self.steps_per_mm
        fast = round(c.homing_speed_mm_s * spm)
        slow = fast  # the second touch is as fast as the seek: the switch stops it at once
        clearance = round(c.homing_clearance_mm * spm)
        release_max = round(c.homing_release_max_mm * spm)
        accel = round(c.homing_accel_mm_s2 * spm)
        max_steps = self.max_position + round(20 * spm)
        timeout = (
            motion_time(max_steps, fast, accel)
            + motion_time(release_max, fast, accel)
            + motion_time(release_max + 2 * clearance, slow, accel)
        )
        reply = await self._motion(
            "HOME", fast, slow, clearance, max_steps, release_max, accel, timeout=timeout
        )
        self._update(homed=True)
        release = int(reply.get("release", 0))
        self._log.info(f"Homed. The switch releases {release / spm:.2f} mm past where it trips.")
        # Park where the switch is open again, so it rests released and armed.
        park = min(max(self.min_position, release + clearance), self.max_position)
        await self.move_to(park, fast, accel)

    async def move_to(self, target: int, speed: float, accel: float) -> int:
        if not self._state.homed:
            raise AxisError(_ERRORS["NOT_HOMED"])
        if not self.min_position <= target <= self.max_position:
            raise AxisError(_ERRORS["LIMIT"])
        distance = abs(target - self._state.position)
        await self._motion(
            "MOVE", target, round(speed), round(accel), timeout=motion_time(distance, speed, accel)
        )
        return self._state.position

    async def jog(self, delta: int, speed: float, accel: float) -> int:
        if self._state.homed and not (
            self.min_position <= self._state.position + delta <= self.max_position
        ):
            raise AxisError(_ERRORS["LIMIT"])
        await self._motion(
            "JOG", delta, round(speed), round(accel), timeout=motion_time(abs(delta), speed, accel)
        )
        return self._state.position

    async def stop(self) -> None:
        # Always sent: the controller ignores it when idle, and the local `moving` flag can
        # briefly lag a motion that has just been started.
        if self._link is not None:
            await self._request("STOP")
