Sam-de-Ham/MacroRail/(commit log)

2026-10-18 Initial project docs and rail hardware files
    [01_motor_end_block.stl, 02_far_end_block.stl, 03_carriage.stl, 04_floating_nut_carrier.stl, 05_sample_platform.stl, 06_endstop_trigger.stl]
2026-10-18 Add project scaffold, rail firmware, protocol and motion layer
    - uv project with ruff, mypy (strict) and pytest; CI workflow
    - Nano firmware (PlatformIO): TMC2209 over UART, StealthChop, homing,
    soft limits, link watchdog, driver fault checks
    - Line protocol spec, request/response link with id matching
    - RailAxis with reconnects, and a simulated controller for tests and --sim
2026-10-18 Add camera layer, stack engine and orchestrator
    - Camera protocol with a gphoto2 backend (trigger + FILE_ADDED, one worker
    thread, re-init and single retry) and a simulated camera with live view
    - Stack planning that always covers the whole range; a runner with
    pause/resume, stop-and-return, camera-error pause and per-stack records
    - Machine orchestrator: one operation at a time, backlash-aware approach,
    range preview sweep, idle hold-current policy, persisted settings
    - Live-view fan-out and single-controller lease
    [base.py]
2026-10-19 Add web API and mobile-first web UI
    - FastAPI REST commands guarded by the control lease, WebSocket state
    and activity push, MJPEG live view, stop allowed from any device
    - Plain ES-module UI: live view with tap-to-zoom, position and jog,
    focus range, stack progress, settings sheet, activity log
    - macrorail CLI with --sim; API and live-view tests
2026-10-19 Add Raspberry Pi install, service and dev deploy scripts
2026-10-19 Add docs: README, architecture, wiring, changelog; show switch state in UI
2026-10-19 Fix review findings and tidy the signal pins
    - Stop always reaches the controller; checked after motor preparation
    and between approach legs; works while a stack returns to start;
    a stop during a stack's approach stays in place
    - A second Start no longer replaces a running stack
    - gphoto2 camera reports live view and reconnects right after a loss
    - Covering shot is clamped to the travel limit; ETA ignores paused time
    - Firmware: drop HALT, report driver faults once, larger TX buffer,
    TMC UART moved to D7/D8 so signals sit on D3-D8
    - Remove unused move/clear endpoints; tests for link, watchdog,
    gphoto2 (fake module) and the stop paths
    [base.py, config.h, main.cpp]
2026-10-19 Treat the home switch as normally-open, matching the rail's wiring
2026-10-19 Close the camera session cleanly when the app shuts down
2026-10-19 Invert motor direction to match the rail's wiring
    [config.h]
2026-10-19 Keep rail and camera supervisors alive on unexpected errors; log shutdown failures
    [rail.py]
2026-10-19 Make the home switch interrupt-driven and always armed
    - Switch on D2 (INT0): the first contact latches a trip and stops any
    motion before its next step, in either direction; only a move that
    starts on the pressed switch and backs away ignores it
    - Moves toward a pressed switch are refused; SWITCH events push every
    level change to the host, which also clears homed on ENDSTOP at once
    - Simulator mirrors the behaviour; tests for stop-in-any-direction,
    pushed switch state, backing off and a stuck switch
    [config.h, main.cpp, rail.py]
2026-10-19 Make the serial link half-duplex around the driver UART
    The Nano's software UART to the TMC2209 blocks interrupts and dropped
    bytes arriving from the Pi (seen as ERR UNKNOWN / ERR SYNTAX and link
    resets). The firmware now talks to the driver only while answering a
    request (idle STATUS, ENABLE, CURRENT), and the host sends nothing while
    a request is unanswered; motion requests free the line once sent.
    [link.py, main.cpp, rail.py]
2026-10-19 Add a live view pause toggle and show the shot count on the Start button
2026-10-19 Update notes: switch timing, live view toggle, bring-up status
2026-10-19 Home by backing off until the switch releases; slower seek
    - HOME backs off until the switch has released (plus a clearance, up
    to a limit) instead of a fixed 1 mm, and reports the release distance
    - After homing, park past the release point so the switch rests open
    - A move that starts on the pressed switch re-arms it once released
    - Seek at 1 mm/s; simulator models switch hysteresis
    [base.py, main.cpp, rail.py]
2026-10-19 Bump the rail protocol to v2 (HOME arguments, SWITCH events)
2026-10-19 Take the switch's first blip while homing; keep the noise filter elsewhere
    [main.cpp]
2026-10-19 Prepare v1.0.0: setup guide in the repo, release date, tidy
    - Setup guide (PDF plus its generator) moves into docs/setup-guide, with
    generic install and flash steps
    - Link the guide from the README and wiring doc; date the changelog
2026-10-19 Upkeep: Node 24 CI actions, CI badge, robust switch tests, numpy and Pillow as core deps
2026-10-19 Add focus scans: auto start/end detection and backlash measurement
    - Tile sharpness from live-view frames (Laplacian energy on an 8x6 grid)
    - Auto range: each detailed tile's in-focus band; the range spans them all
    - Backlash: forward/backward passes through a detail's focus peak, fitted
    - Optics settings and depth-of-field maths for steps and scan spacing
    - Simulator: lead-screw backlash model, camera follows the carriage, and
    smooth focus rendering on a continuous dome
2026-10-19 Add camera settings, stack names, preview downloads and the review store
    - Camera: curated gphoto2 settings (read, change, refreshed), file
    download, and the confirmed file's folder in each capture
    - Stacks get a name and a folder: record, small JPEG copies downloaded
    while the stage moves on, and a quick focus-stacked preview at the end
    - API for scans, camera settings and the review gallery
2026-10-19 Add diagnostics: driver health, link stats and Pi system health
    - Firmware DRIVER command (protocol v3): DRV_STATUS decoded, configured
    currents, microsteps, controller uptime; simulator mirrors it
    - Rail link stats: connections, uptime, smoothed STATUS round trip
    - Pi: temperature, power/throttle flags, load, memory, disk, uptime
2026-10-19 Tabbed UI, installable app and stack alerts
    The interface is reorganised around a fixed live view with Shoot, Camera,
    Review and System tabs, a status strip for whatever is running, and a
    step-size helper. MacroRail can be installed as an app, and it chimes,
    vibrates and notifies when a stack needs attention.
    Backlash is now measured by matching the forward and backward passes
    through focus as whole curves, which stays exact when the top of the
    curve is broad; the sweep covers up to 0.25 mm of backlash. Scans return
    the rail to where they began.
2026-10-21 CI: pin setup-uv to v10.3.0, which has no floating v10 tag
2026-10-21 Depth map with each preview stack, shown in false colour and as a 3D relief
    The preview stack now also records each pixel's winning-frame focus height, smoothed
    by sharpness, with detail-free background faded to the far end. It is saved as a 16-bit
    grey PNG (for Blender) and a false-colour JPEG, served by the API and added to the zip.
    Review gains Depth and 3D modes; the 3D view is plain WebGL 2 with the stack as texture,
    drag to turn, pinch or scroll to zoom, a height slider and a flip.
2026-10-21 Record the 3D-scanning design direction: v1 module with motorised yaw, manual centring and tilt
2026-10-21 3D scanning: keep 2D unchanged behind a mode switch, pick the 28BYJ-48 for yaw
2026-10-21 3D scanning: mount on the carriage holes, height clamp plus Z screw
2026-10-21 Scan module: round 2 answers, concept sketches and the lens-clearance findings
2026-10-21 3D scanning: v1 module design and CAD plan (direct-drive tilt, yaw head on the motor shaft)
2026-10-21 Scan module: full Fusion 360 model from stage scripts, verified, test pieces exported
    [axle-spacer.stl, carriage-washer.stl, centring-plate.stl, height-gauge.stl, knob.stl, pin-pad.stl, puck.stl, spring-plunger.stl]
2026-10-21 Scan module: hex-key screws, wider uprights, tilt home interface, assembly guide PDF, final STLs
    - Knobs removed: centring and pad screws are turned with a 2 mm hex key.
    - Uprights widened to 44.2 mm so the tilt motor's ear bolts land inside them.
    - Tilt home: endstop bracket holes and nut pockets on the +Y upright, flag bolt through
    the +Y arm (reaches the switch at about +95 deg). The bracket waits for measurements.
    - Base test piece is now the bottom 2.5 mm only.
    - explode parameter and guide renders; 7-page assembly and usage guide.
    - STLs exported to exports/test-pieces and exports/final; old renders removed.
    [axle-spacer.stl, carriage-washer.stl, centring-plate.stl, cradle.stl, fork.stl, height-gauge.stl, knob.stl, pin-pad.stl]
2026-10-21 Scan module: one-piece specimen holder, tilt home switch bracket
    - Puck and centring plate merged into one Specimen Holder: no magnets, domes or V-grooves.
    The seat gap went into the neck (6.5 mm), so every height below the insect is unchanged.
    - Endstop Bracket for the measured roller microswitch: bolted to the +Y upright with two
    M3 x 11.8, switch held by two small wood screws in pilot holes plus glue. The flag meets
    the roller at +90 deg and clicks it at home_t = 97 deg; 2.3 mm clearance at +100 deg.
    - Upper bracket hole moved to 12 mm below the axis (bolt head stays out of the flag sweep).
    - Full rebuild from the stage scripts: 59 bodies, healthy, fully constrained, verified.
    - Gui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
    [centring-plate.stl, endstop-bracket.stl, fork.stl, puck.stl, specimen-holder.stl, tp-bearing-seat.stl]
2026-10-22 Scan module: test round 1 fixes, simpler head, detailed assembly guide
    - Motor-side upright 4 mm (was 6): the tilt shaft now reaches 6.2 mm into the cradle hub.
    - Tilt D-bore gets its own fit (fit_Dt 0.05; it prints on its side and 0.2 was far too loose).
    - 608 seat +0.1, magnet pocket +0.2, pin hole 1.0 -> 1.2.
    - Pin clamp: no pad. One M3 screw on a straight line through a captive nut; the slot is
    5.5 mm with the flats up and down so the nut can't turn.
    - No spring plunger: the spring pushes straight on the holder rim; bore shortened for preload.
    - Full rebuild from the stage scripts, verified; STLs and guide renders re-exported.
    - Guide rewritten: tools, round 2 test pieces, assembly in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
    [axle-spacer.stl, cradle.stl, fork.stl, pin-pad.stl, specimen-holder.stl, spring-plunger.stl, tilt-axle.stl, tp-bearing-seat.stl]
2026-10-23 Scan module: tighter yaw D-bore (fit_D 0.1), guide explains why the tilt hub needs no set screw
    [yaw-head.stl]
2026-10-24 3D scanning: hardware done
    - Status everywhere: module printed and assembled (2026-10-24); no software yet.
    - docs/3d-scanning.md: software plan (order of work, wiring, firmware, simulator, host, UI)
    and the facts the code needs; stale clamp, dimension and lens-check text fixed.
    - Module README: status, folder map, open checks that need power; MEASUREMENTS: superseded
    planning values marked with their final parameters.
    - Guide: yaw homes on the hall sensor's analog peak, not the board's on/off output.
2026-10-24 3D scanning: module firmware, host driver, Rig tab, calibration (milestones 1-2)
    - firmware-module/: the scan module's own Nano (protocol v1): tilt homing on its switch,
    yaw homing on the hall field peak, soft limits, watchdog; adversarially reviewed.
    - Host: ScanModule driver, port auto-discovery (exclusive opens, USB ports only), Poser
    with take-up arrivals, machine operations and API.
    - UI: 2D/3D workspace switch; Rig tab with tilt/yaw gauges, jogs, poses; Scan module
    card with diagnostics, hall meter and calibration.
    - Calibration: yaw half-steps per turn from two homings; tilt level from a needle at
    +/-10 deg. Stored in module.json so settings.json stays readable by main.
    - Simu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
2026-10-24 3D scanning: centring wizard, scans, scan review and export (milestones 3-5)
    - Centre tab: four-yaw centring rounds with a fit plot and screw dials, height from
    +/-20 deg tilt, and a live-view line where the yaw axis appears.
    - Scan tab: tilt rings x yaw step plan with a pose map, estimate and pre-flight checks;
    test one pose; pause, resume, stop, and continue after a stop or restart.
    - Each pose: turn, auto range (falling back to the last one), stack, preview and depth
    map, then keep one frame in n. scan.json is written after every pose.
    - 3D Review: scans with pose thumbnails into the usual viewer; a 'Download for 3D' zip
    with one all-in-focus image per pose, depth maps and a pose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
2026-10-24 3D scanning: review fixes for centring, scans and the 3D UI
    - A scan always ends with a final, recorded outcome (also when stopped while homing yaw
    or on an unexpected error); a pose without a range stops the scan so you can
    focus and continue, and the rail goes back where it looked.
    - Each scan fixes its step, stack settle and focus span in its record; those settings
    can't change mid-scan. Ranges are clamped to the rail; the estimate counts the moves
    to the start and the preview stacks. The 2D range is kept through a scan.
    - Thinning frames runs off the event loop; the export skips a deleted pose.
    - UI: Review can't go blank between 2D and scans, a scan load race is gone, the pose m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
2026-10-24 3D scanning: last verification fixes
    - Continue refuses any damaged scan record cleanly instead of failing with a server error.
    - A Stop just before a scan's yaw homing is no longer missed.
    - The scan-stopped alert carries the reason (such as the specimen not being found); a
    failed scan load no longer closes another scan opened meanwhile.
2026-10-24 Scan module: pins for the reused Nano (yaw D4-D7, tilt D8, D9, D11, D12)
    The reused Nano already has a ULN2003 soldered to D4-D7, so yaw takes those and tilt moves
    to D8, D9, D11, D12 (D10 stays the switch). Firmware config, protocol docs and the
    wiring guide (pictures, legend, checklist) follow. The guide now also says to remove an RST-GND capacitor from a reused Nano: the app relies
    on the reset when the port opens.
    [config.h]
2026-10-24 Scan module: pins as wired on the rig (yaw D2-D5, tilt D6, D7, D9, D11); Module test card
    - Firmware config, guide (pictures, legend, checklist) and docs follow the rig's wiring.
    - System (3D) gains a Module test card: the switch, hall reading, raw half-steps and
    angles of both axes, motion and link, plus one forward and one back button per motor
    (the Rig tab's step), and a Stop.
2026-10-24 Scan module: tilt IN1 and IN2 swapped to D7 and D6, as wired on the rig
    [config.h]
2026-10-24 3D: screws face 180 deg round, greyed-out buttons say why, manual tilt option
    - Screw X points away from the camera at yaw 0 on the rig: one constant
    (SCREW_X_YAW_DEG) drives the centring fit, the screw advice and its 'to you' yaws,
    the yaw gauge and the simulator's head.
    - Tapping a greyed-out 3D button shows why it is greyed out.
    - Manual tilt (System, 3D): the tilt motor is left alone and needn't be homed; tilt
    controls, Level tilt and Height are hidden; centring works at the tilt set by hand; a
    scan pauses before each tilt ring to set it by hand, and alerts.
2026-10-24 Rig feedback: screw access angle, self-checking screw directions, Spin, module keeps homing, faster rail homing
    - Screw X points at the camera at yaw 0 after all (the 180 deg change was a misreading:
    you stand on the camera side). 'Screw to you' now turns a screw to an angle set in
    the Centre tab (default 45 deg, beside the objective).
    - Each centring round checks the last advice against how the plate moved; a screw that
    moved it the other way has its direction flipped and remembered.
    - Spin (Centre tab) turns yaw until Stop, for centring by eye. After a large correction the
    next round's first sweep looks further; height sweeps one frame per depth of field.
    - The module's port is reo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
    [link.py, module.py, ports.py]
2026-11-01 Steadier simulator tests, stricter lint and type checks, small code cleanups
    The simulator threads now end with their simulator and catch up in normal-sized steps when
    the machine is busy, so the timing-sensitive tests no longer starve each other. Ruff gains
    more rule sets, mypy covers the tests and scripts, and Biome lints the web UI.
    [base.py, config.h, link.py]
2026-11-01 Build guides for the rail and the scan module, with renders of both
2026-11-01 README: the rail and the add-on scan module, screenshots, how it works
