Sam-de-Ham/MacroRail/(notices)

Notices in the files:
README.md:
License: PolyForm Noncommercial
